heathrampazis/splitter/hardware/case/preview/base.png

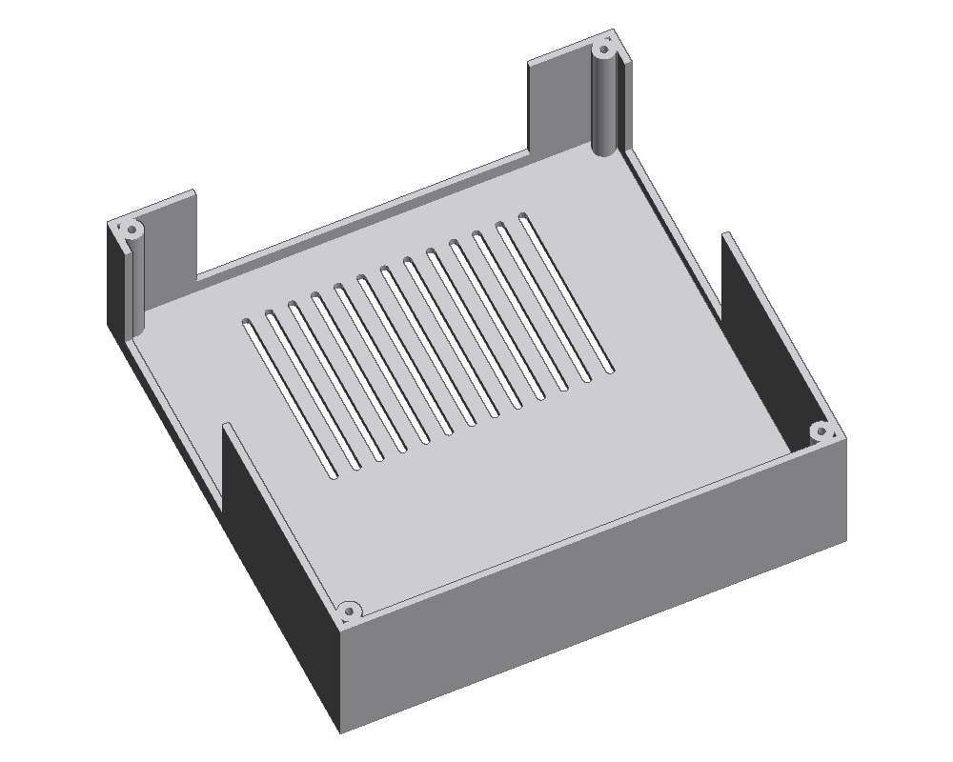
hardware/case/preview/base.png
