heathrampazis/splitter/hardware/case/preview/button_bars.png

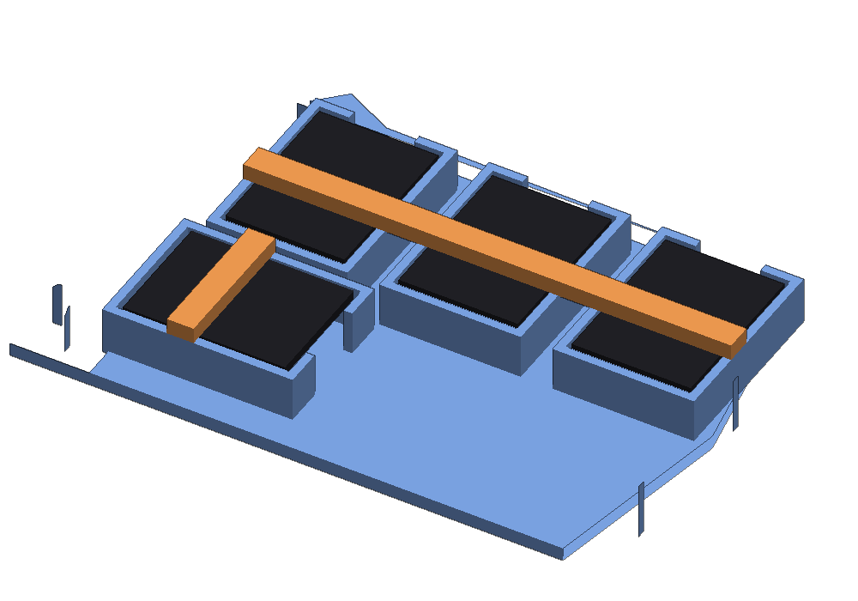
hardware/case/preview/button_bars.png
