heathrampazis/splitter/hardware/case/preview/button_cable_gaps.png

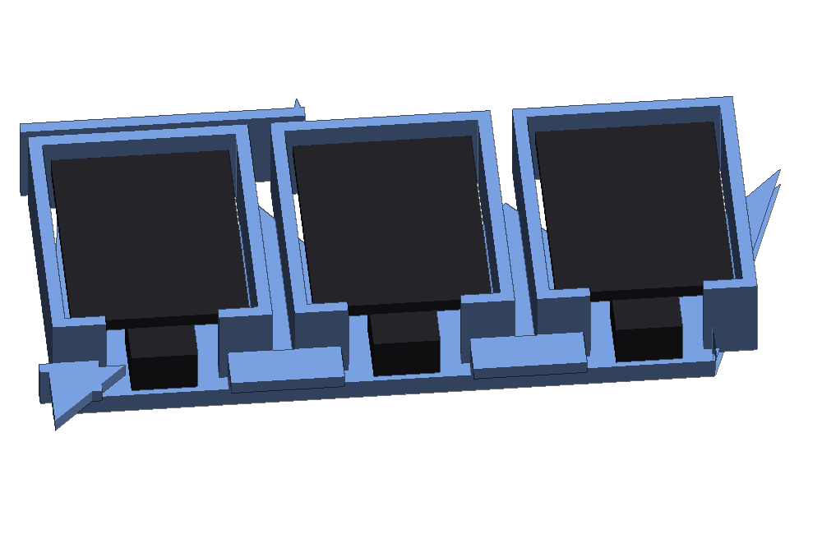
hardware/case/preview/button_cable_gaps.png
