heathrampazis/splitter/hardware/case/preview/button_cap.png

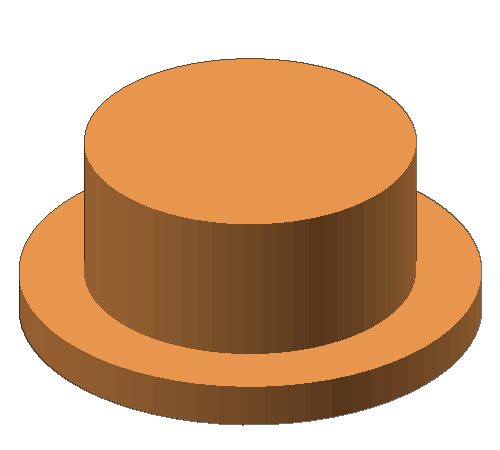
hardware/case/preview/button_cap.png
