heathrampazis/splitter/hardware/case/preview/encoder_pillars.png

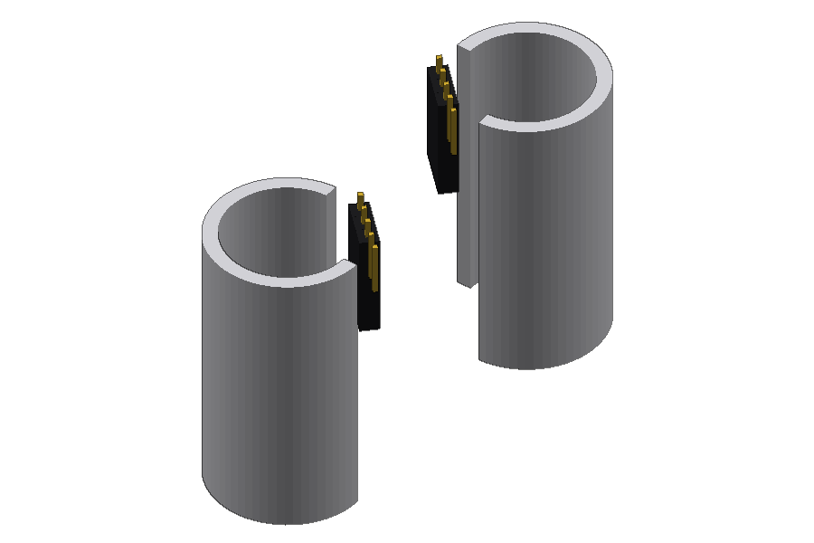
hardware/case/preview/encoder_pillars.png
