heathrampazis/splitter/hardware/case/preview/jog_knob.png

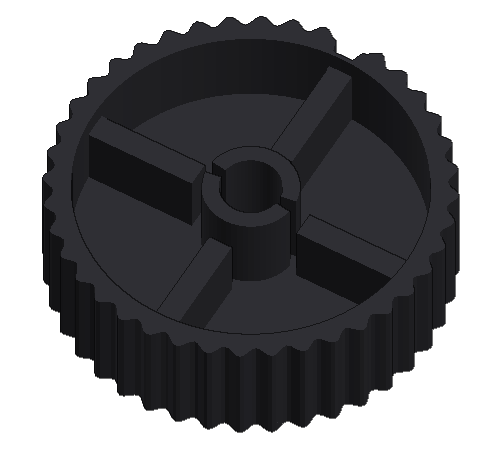
hardware/case/preview/jog_knob.png
