heathrampazis/splitter/hardware/case/preview/tempo_knob.png

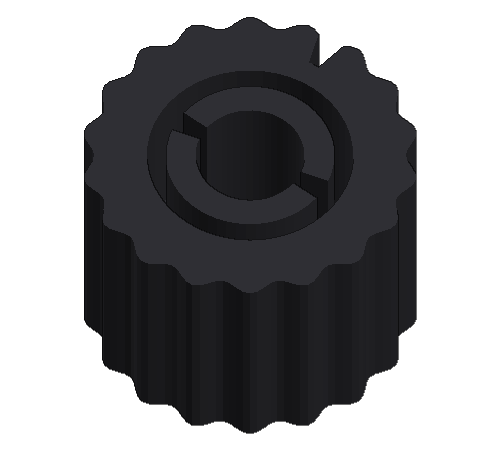
hardware/case/preview/tempo_knob.png
