heathrampazis/splitter/hardware/case/stl/tempo_knob.stl

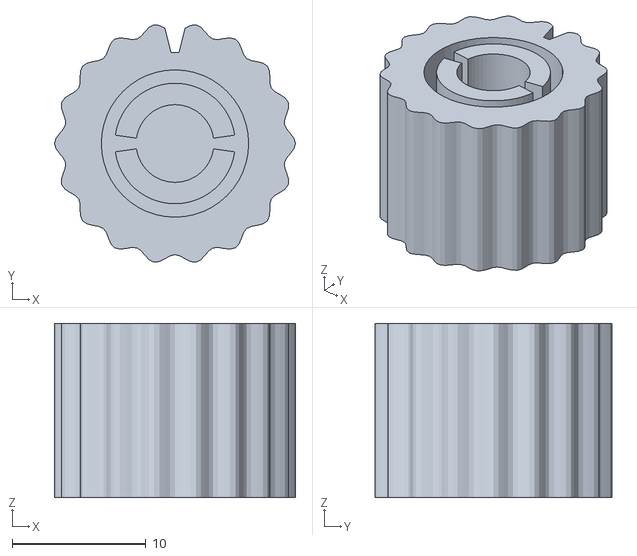
[picture p12: CAD file, 2026-10-29]
hardware/case/stl/tempo_knob.stl
18.0 x 17.7 x 13.0
