heathrampazis/splitter/hardware/case/stl/button_bar_play.stl

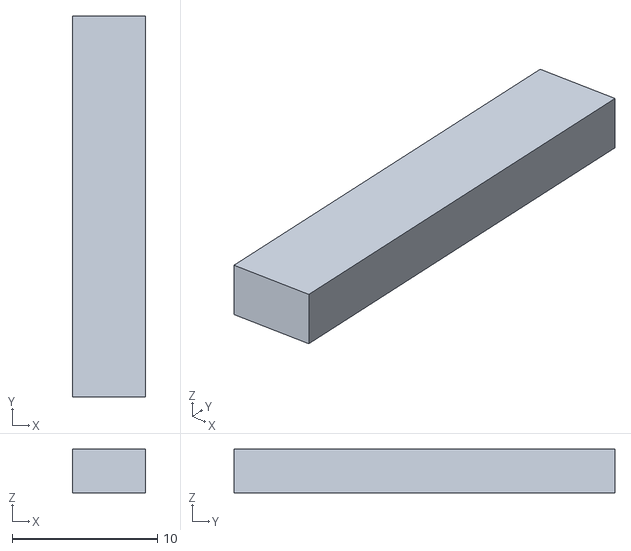
[picture p13: CAD file, 2026-10-29]
hardware/case/stl/button_bar_play.stl
5.00 x 26.2 x 3.00
