heathrampazis/splitter/hardware/case/stl/top_panel.stl

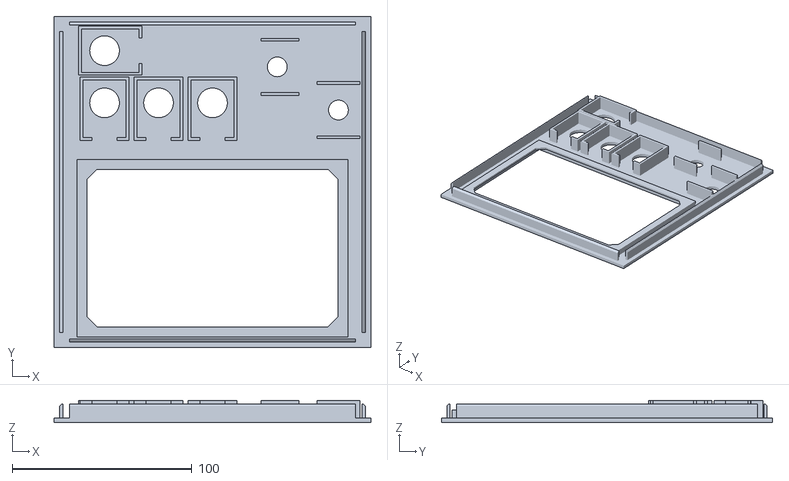
[picture p14: CAD file, 2026-10-29]
hardware/case/stl/top_panel.stl
176.0 x 184.0 x 12.5
