heathrampazis/splitter/hardware/case/stl/button_bar_stems.stl

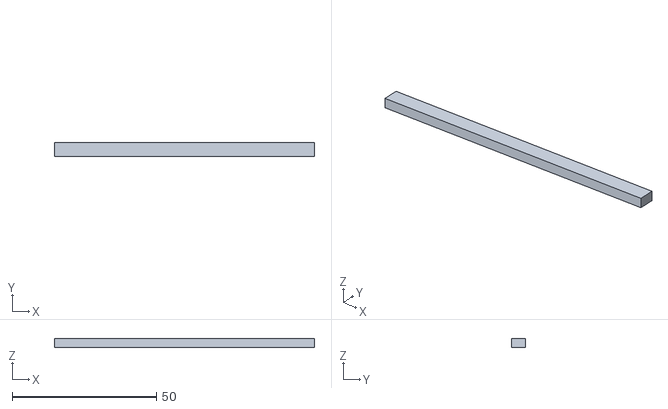
[picture p15: CAD file, 2026-10-29]
hardware/case/stl/button_bar_stems.stl
90.2 x 5.00 x 3.00
