heathrampazis/splitter/hardware/case/stl/jog_knob.stl

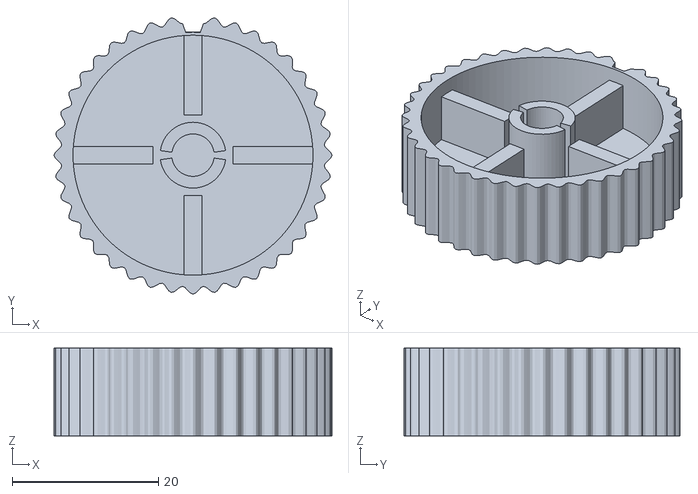
[picture p16: CAD file, 2026-10-29]
hardware/case/stl/jog_knob.stl
38.0 x 37.8 x 12.0
