heathrampazis/splitter/hardware/case/stl/base.stl

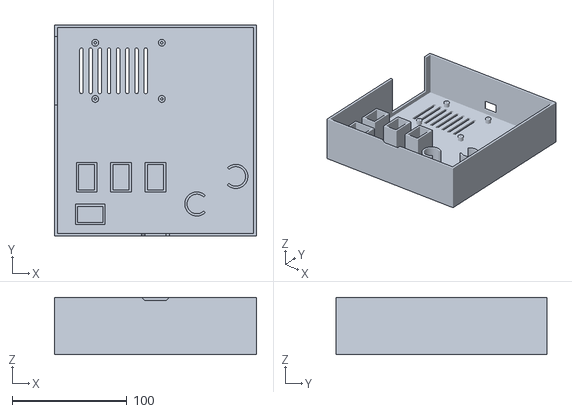
[picture p17: CAD file, 2026-10-29]
hardware/case/stl/base.stl
176.0 x 184.0 x 50.0
