heathrampazis/splitter/hardware/case/stl/button_cap.stl

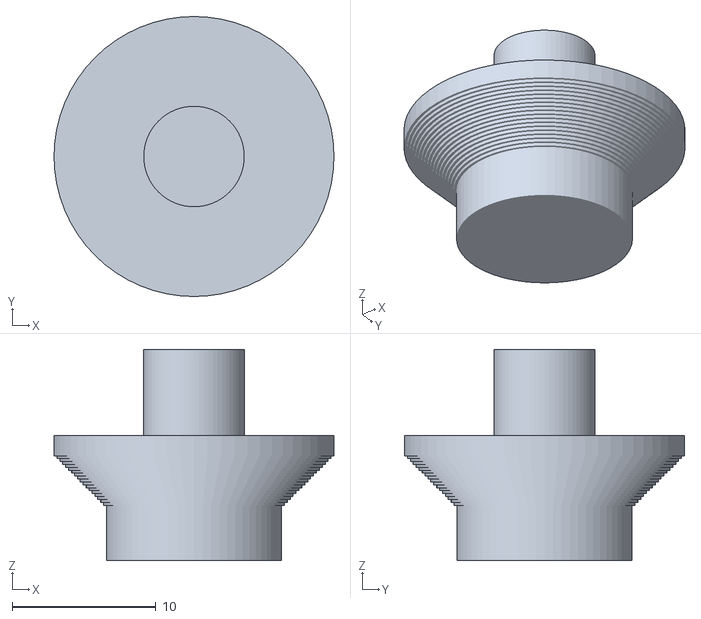
[picture p18: CAD file, 2026-10-27]
hardware/case/stl/button_cap.stl
19.5 x 19.5 x 14.7
