heathrampazis/splitter/hardware/case/stl/screen_frame.stl

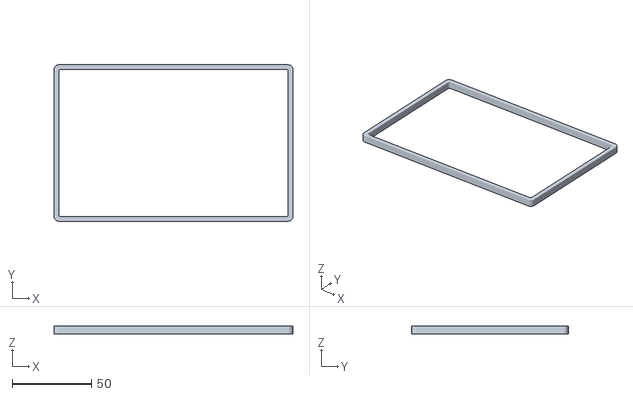
[picture p19: CAD file, 2026-10-27]
hardware/case/stl/screen_frame.stl
150.7 x 98.7 x 5.00
