heathrampazis/splitter/hardware/case/stl/encoder_washer.stl

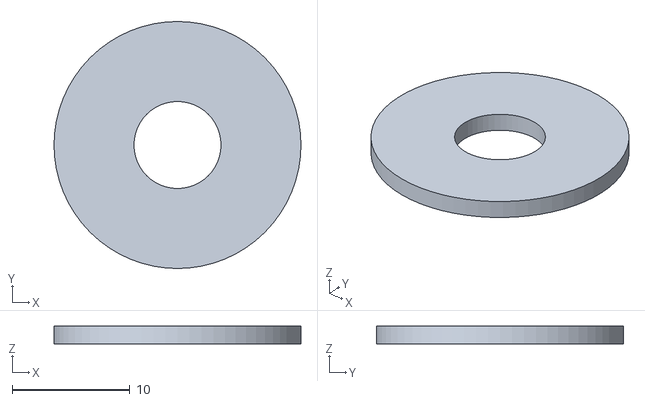
[picture p20: CAD file, 2026-10-27]
hardware/case/stl/encoder_washer.stl
21.0 x 21.0 x 1.50
