heathrampazis/splitter/(commit log)

2026-10-25 updated for pico
2026-10-26 Added latest firmware and case models
2026-10-26 added support for raspberry pi
2026-10-27 updated for button support + ui changes
2026-10-27 added case
2026-10-27 updated case
2026-10-27 updated case design
2026-10-27 removed old case files
